cyfinfaza/RSC-LV3-LVBPS/RSC-LV3-LVBPS.kicad_pcb

## KiCad design RSC-LV3-LVBPS.kicad_pcb (2026-06-22)

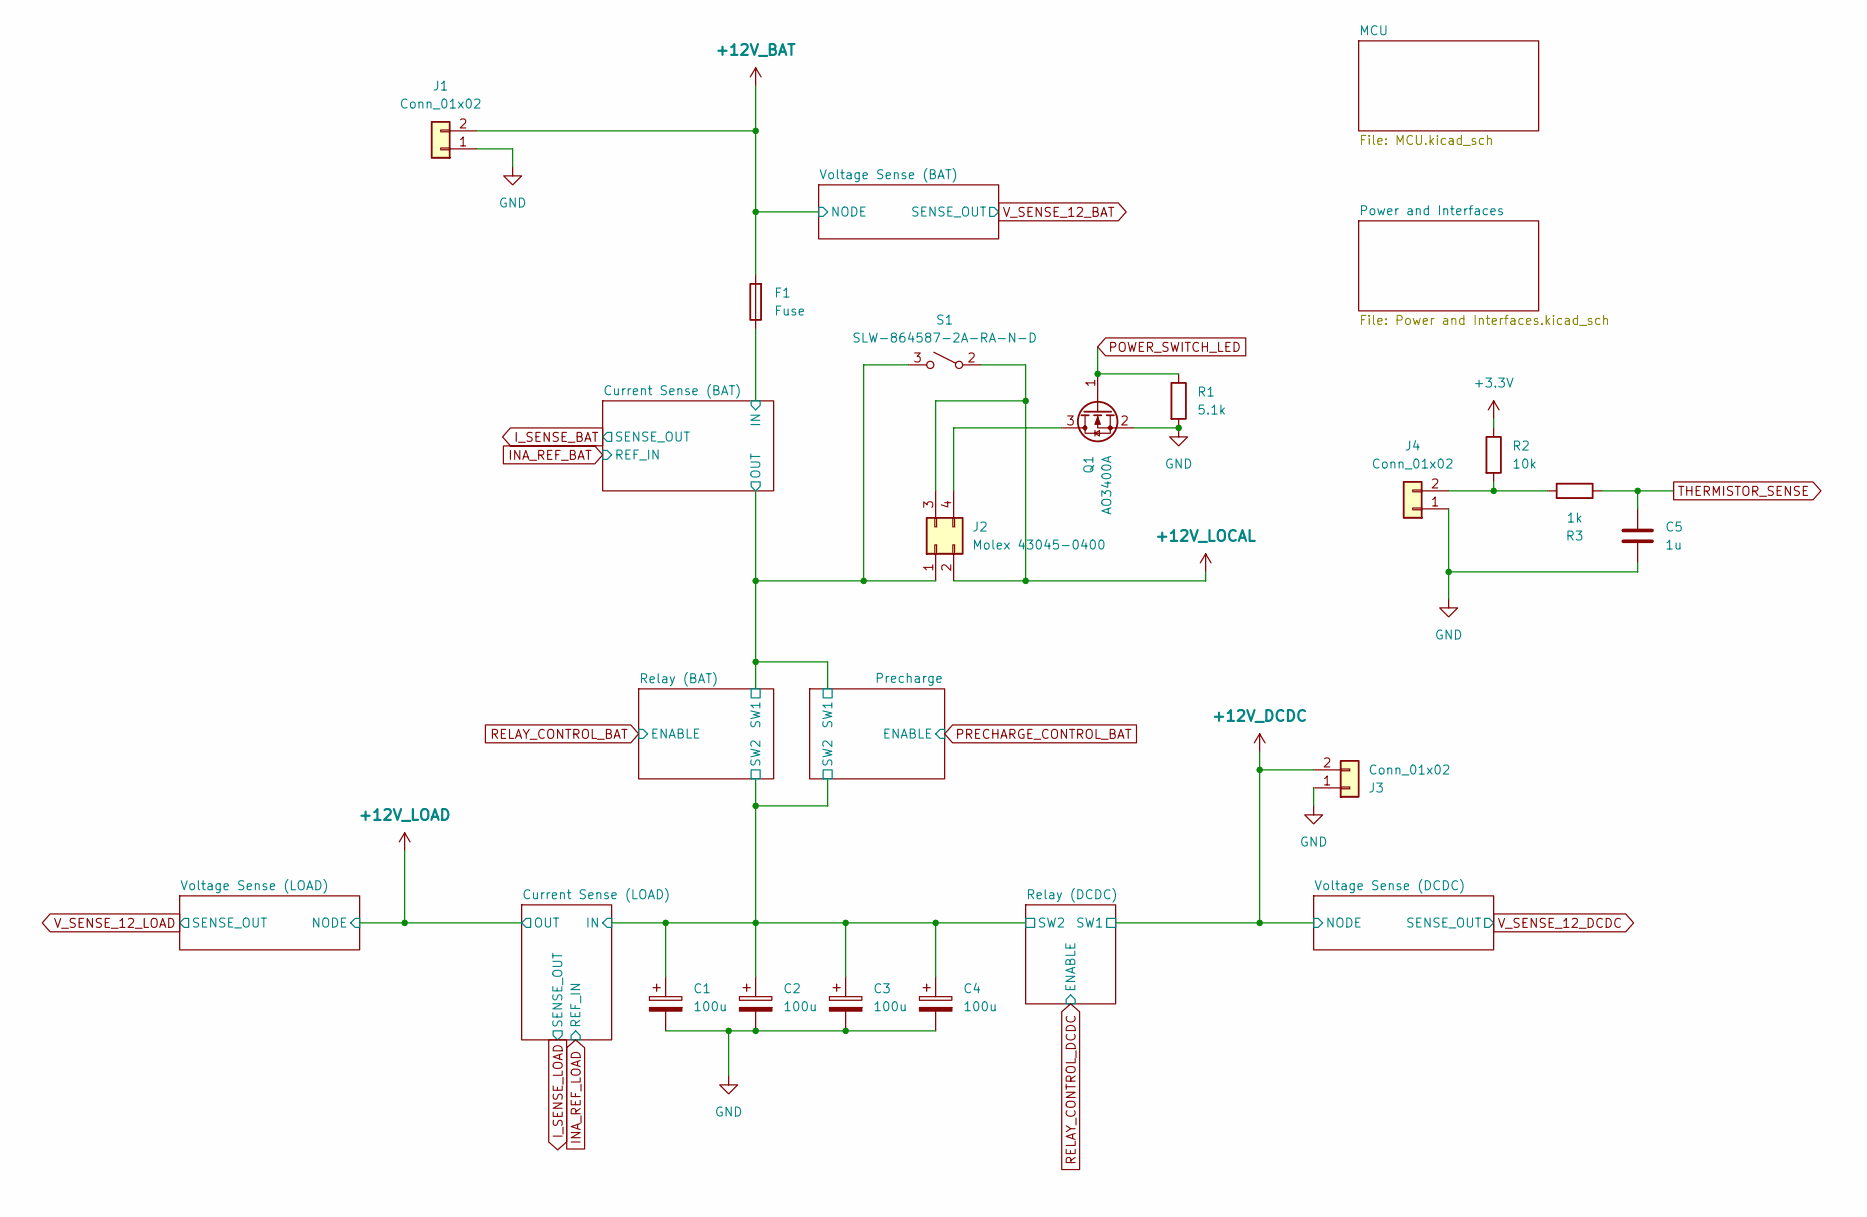
[picture p1: schematic RSC-LV3-LVBPS.kicad_sch]

Parts:
C1, C2, C3, C4: 100u; CP_Radial_D6.3mm_P2.50mm
C5: 1u; C_0603_1608Metric_Pad1.08x0.95mm_HandSolder
F1: Fuse; Fuseholder_Blade_Mini_Keystone_3568
J1, J3, J4: Conn_01x02; Molex_Micro-Fit_3.0_43650-0200_1x02_P3.00mm_Horizontal_Vert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
J2: Molex 43045-0400; Molex_Micro-Fit_3.0_43045-0400_2x02_P3.00mm_Horizontal_Vert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
Q1: AO3400A; SOT-23
R1: 5.1k; R_0603_1608Metric_Pad0.98x0.95mm_HandSolder
R2: 10k; R_0603_1608Metric_Pad0.98x0.95mm_HandSolder
R3: 1k; R_0603_1608Metric_Pad0.98x0.95mm_HandSolder
S1: SLW-864587-2A-RA-N-D; SLW8645872ARAND

Connections:
+3.3V: R2.1; also elsewhere on the board
+12V_BAT: F1.2, J1.2; also elsewhere on the board
+12V_DCDC: J3.2; also elsewhere on the board
+12V_LOCAL: J2.2, J2.3, S1.2 (A); also elsewhere on the board
/Current Sense (BAT)/IN: F1.1; also elsewhere on the board
/Current Sense (BAT)/OUT: J2.1, S1.3 (B); also elsewhere on the board
/Current Sense (LOAD)/IN: C1.1, C2.1, C3.1, C4.1; also elsewhere on the board
GND: C1.2, C2.2, C3.2, C4.2, C5.2, J1.1, J3.1, J4.1, Q1.2 (S), R1.2; also elsewhere on the board
unnamed: J2.4, Q1.3 (D)
unnamed: J4.2, R2.2, R3.2
POWER_SWITCH_LED: Q1.1 (G), R1.1; also elsewhere on the board
THERMISTOR_SENSE: C5.1, R3.1; also elsewhere on the board

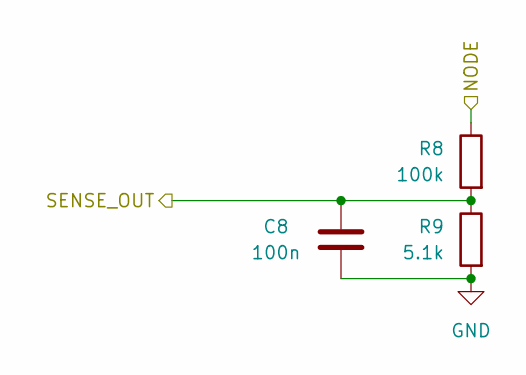
[picture p2: schematic Voltage Sense Network.kicad_sch]

Parts:
C8: 100n; C_0603_1608Metric_Pad1.08x0.95mm_HandSolder
R8: 100k; R_0603_1608Metric_Pad0.98x0.95mm_HandSolder
R9: 5.1k; R_0603_1608Metric_Pad0.98x0.95mm_HandSolder

Connections:
+12V_BAT: R8.1; also elsewhere on the board
GND: C8.2, R9.2; also elsewhere on the board
V_SENSE_12_BAT: C8.1, R8.2, R9.1; also elsewhere on the board

Parts of its further copies:
C9, C10: 100n; C_0603_1608Metric_Pad1.08x0.95mm_HandSolder
R12, R14: 100k; R_0603_1608Metric_Pad0.98x0.95mm_HandSolder
R13, R15: 5.1k; R_0603_1608Metric_Pad0.98x0.95mm_HandSolder

Connections of its further copies:
+12V_DCDC: R14.1; also elsewhere on the board
+12V_LOAD: R12.1; also elsewhere on the board
GND: C9.2, C10.2, R13.2, R15.2; also elsewhere on the board
V_SENSE_12_DCDC: C10.1, R14.2, R15.1; also elsewhere on the board
V_SENSE_12_LOAD: C9.1, R12.2, R13.1; also elsewhere on the board

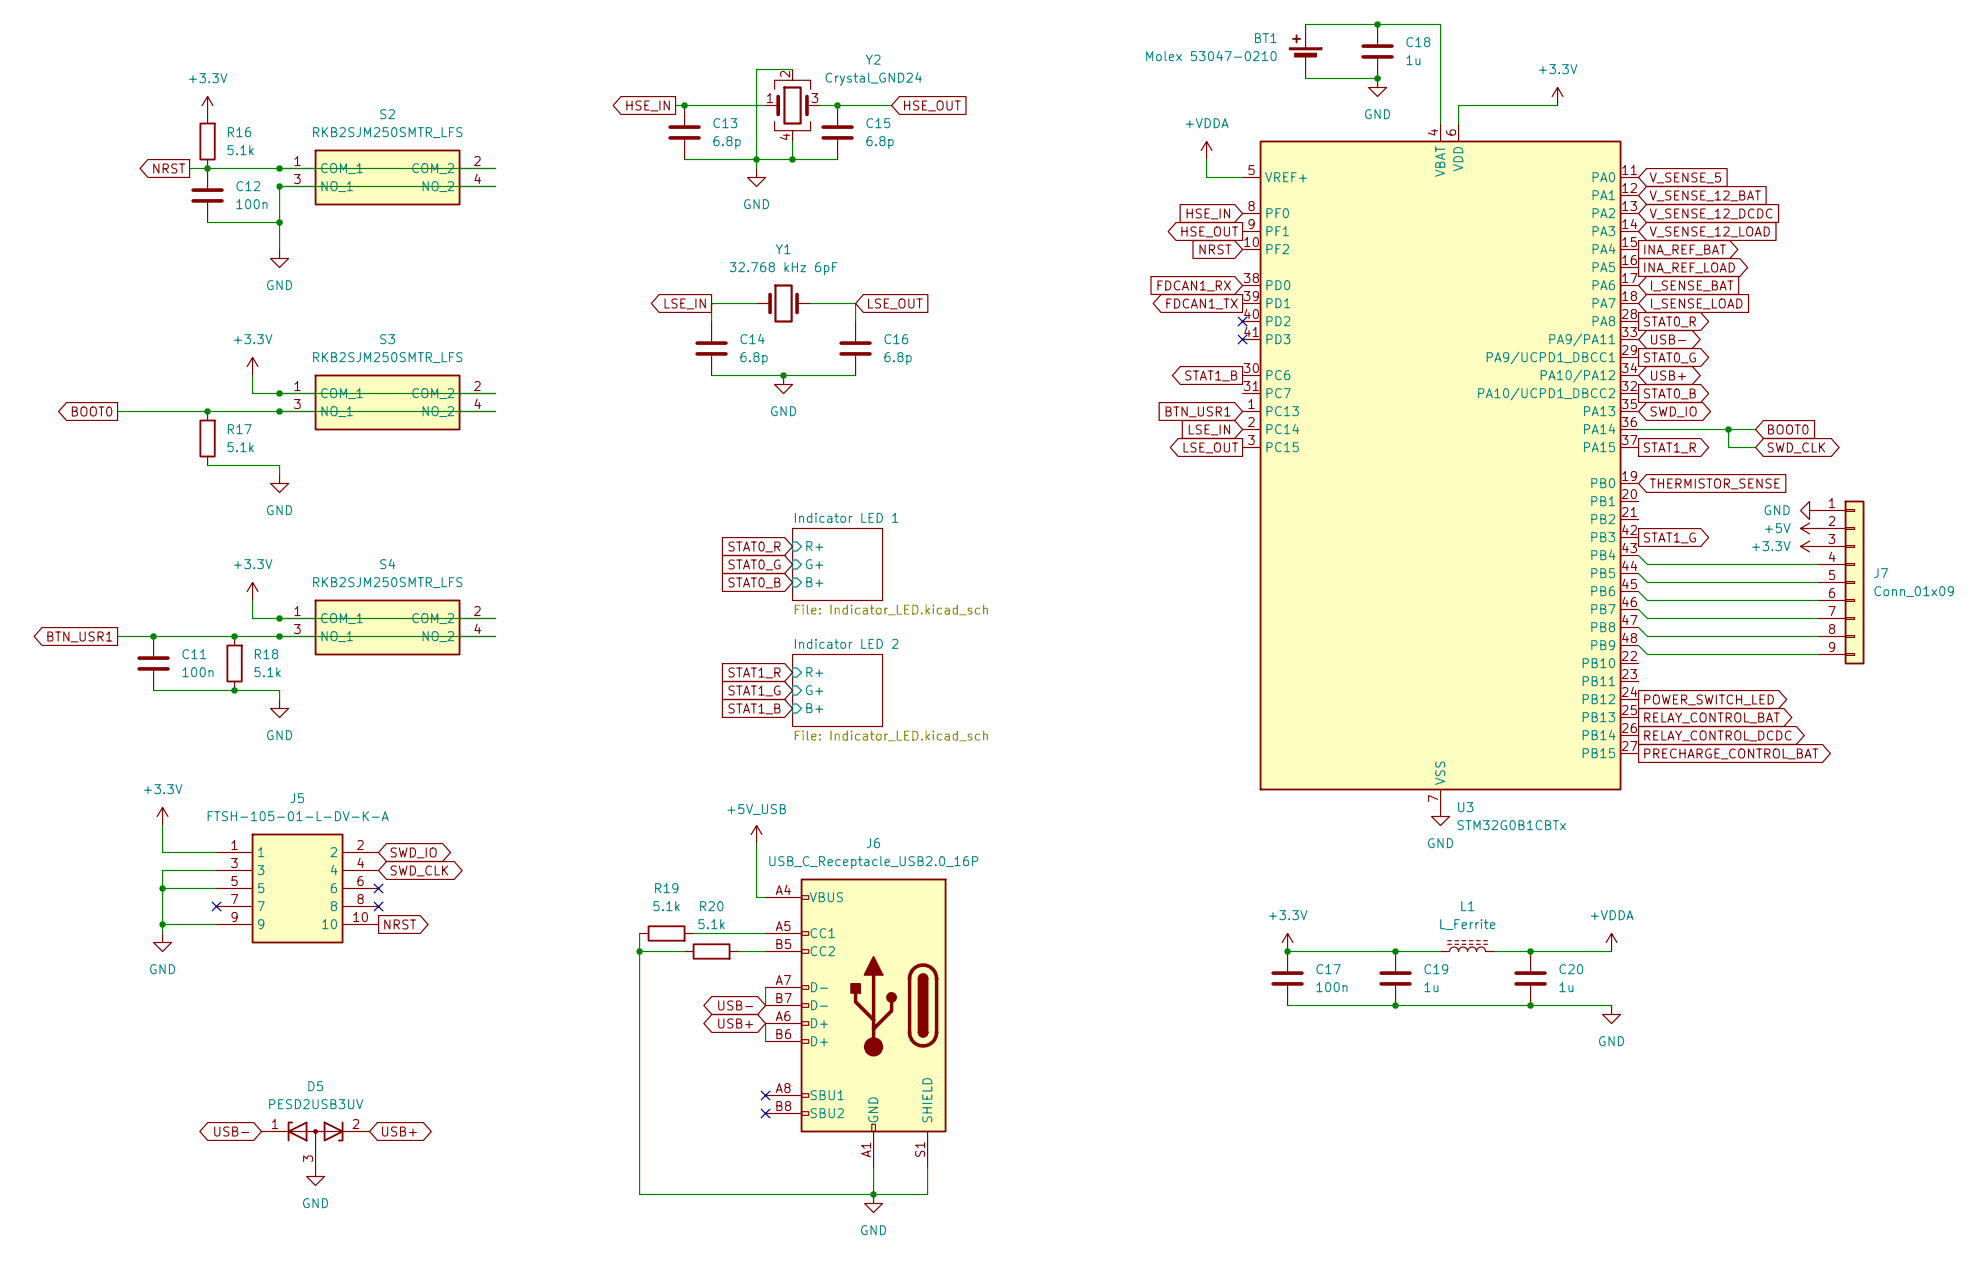
[picture p3: schematic MCU.kicad_sch]

Parts:
BT1: Molex 53047-0210; Molex_PicoBlade_53047-0210_1x02_P1.25mm_Vertical
C11, C12, C17: 100n; C_0603_1608Metric_Pad1.08x0.95mm_HandSolder
C13, C14, C15, C16: 6.8p; C_0603_1608Metric_Pad1.08x0.95mm_HandSolder
C18, C19, C20: 1u; C_0603_1608Metric_Pad1.08x0.95mm_HandSolder
D5: PESD2USB3UV; SOT-23W
J5: FTSH-105-01-L-DV-K-A; FTSH-105-XX-YYY-DV-K-A; Mouser Part Number 200-FTSH10501LDVKA
J6: USB_C_Receptacle_USB2.0_16P; USB_C_Receptacle_HRO_TYPE-C-31-M-12
J7: Conn_01x09; PinHeader_1x09_P2.54mm_Vertical
L1: L_Ferrite; L_0603_1608Metric_Pad1.05x0.95mm_HandSolder
R16, R17, R18, R19, R20: 5.1k; R_0603_1608Metric_Pad0.98x0.95mm_HandSolder
S2, S3, S4: RKB2SJM250SMTR_LFS; RKB2SJM250SMTRLFS; Mouser Part Number 611-RKB2SJM250SMTRLF
U3: STM32G0B1CBTx; LQFP-48_7x7mm_P0.5mm
Y1: 32.768 kHz 6pF; Crystal_C26-LF_D2.1mm_L6.5mm_Horizontal
Y2: Crystal_GND24; Crystal_SMD_3225-4Pin_3.2x2.5mm

Connections:
+3.3V: C17.1, C19.1, J5.1, J7.3, L1.1, R16.2, S3.1 (COM_1), S3.2 (COM_2), S4.1 (COM_1), S4.2 (COM_2), U3.6 (VDD); also elsewhere on the board
+5V: J7.2; also elsewhere on the board
+5V_USB: J6.A4 (VBUS), J6.A9 (VBUS), J6.B4 (VBUS), J6.B9 (VBUS); also elsewhere on the board
+VDDA: C20.1, L1.2, U3.5 (VREF+)
BOOT0: J5.4, R17.2, S3.3 (NO_1), S3.4 (NO_2), U3.36 (PA14)
BTN_USR1: C11.1, R18.2, S4.3 (NO_1), S4.4 (NO_2), U3.1 (PC13)
FDCAN1_RX: U3.38 (PD0); also elsewhere on the board
FDCAN1_TX: U3.39 (PD1); also elsewhere on the board
GND: BT1.2 (-), C11.2, C12.2, C13.2, C14.2, C15.2, C16.2, C17.2, C18.2, C19.2, C20.2, D5.3 (A), J5.3, J5.5, J5.9, J6.A1 (GND), J6.A12 (GND), J6.B1 (GND), J6.B12 (GND), J6.S1 (SHIELD), J7.1, R17.1, R18.1, R19.1, R20.1, S2.3 (NO_1), S2.4 (NO_2), U3.7 (VSS), Y2.2, Y2.4; also elsewhere on the board
HSE_IN: C13.1, U3.8 (PF0), Y2.1
HSE_OUT: C15.1, U3.9 (PF1), Y2.3
INA_REF_BAT: U3.15 (PA4); also elsewhere on the board
INA_REF_LOAD: U3.16 (PA5); also elsewhere on the board
I_SENSE_BAT: U3.17 (PA6); also elsewhere on the board
I_SENSE_LOAD: U3.18 (PA7); also elsewhere on the board
LSE_IN: C14.1, U3.2 (PC14), Y1.1
LSE_OUT: C16.1, U3.3 (PC15), Y1.2
NRST: C12.1, J5.10, R16.1, S2.1 (COM_1), S2.2 (COM_2), U3.10 (PF2)
unnamed: BT1.1 (+), C18.1, U3.4 (VBAT)
unnamed: J6.A5 (CC1), R19.2
unnamed: J6.B5 (CC2), R20.2
unnamed: J7.4, U3.43 (PB4)
unnamed: J7.5, U3.44 (PB5)
unnamed: J7.6, U3.45 (PB6)
unnamed: J7.7, U3.46 (PB7)
unnamed: J7.8, U3.47 (PB8)
unnamed: J7.9, U3.48 (PB9)
POWER_SWITCH_LED: U3.24 (PB12); also elsewhere on the board
PRECHARGE_CONTROL_BAT: U3.27 (PB15); also elsewhere on the board
RELAY_CONTROL_BAT: U3.25 (PB13); also elsewhere on the board
RELAY_CONTROL_DCDC: U3.26 (PB14); also elsewhere on the board
STAT0_B: U3.32 (PA10/UCPD1_DBCC2); also elsewhere on the board
STAT0_G: U3.29 (PA9/UCPD1_DBCC1); also elsewhere on the board
STAT0_R: U3.28 (PA8); also elsewhere on the board
STAT1_B: U3.30 (PC6); also elsewhere on the board
STAT1_G: U3.42 (PB3); also elsewhere on the board
STAT1_R: U3.37 (PA15); also elsewhere on the board
SWD_IO: J5.2, U3.35 (PA13)
THERMISTOR_SENSE: U3.19 (PB0); also elsewhere on the board
USB+: D5.2 (K), J6.A6 (D+), J6.B6 (D+), U3.34 (PA10/PA12)
USB-: D5.1 (K), J6.A7 (D-), J6.B7 (D-), U3.33 (PA9/PA11)
V_SENSE_5: U3.11 (PA0); also elsewhere on the board
V_SENSE_12_BAT: U3.12 (PA1); also elsewhere on the board
V_SENSE_12_DCDC: U3.13 (PA2); also elsewhere on the board
V_SENSE_12_LOAD: U3.14 (PA3); also elsewhere on the board

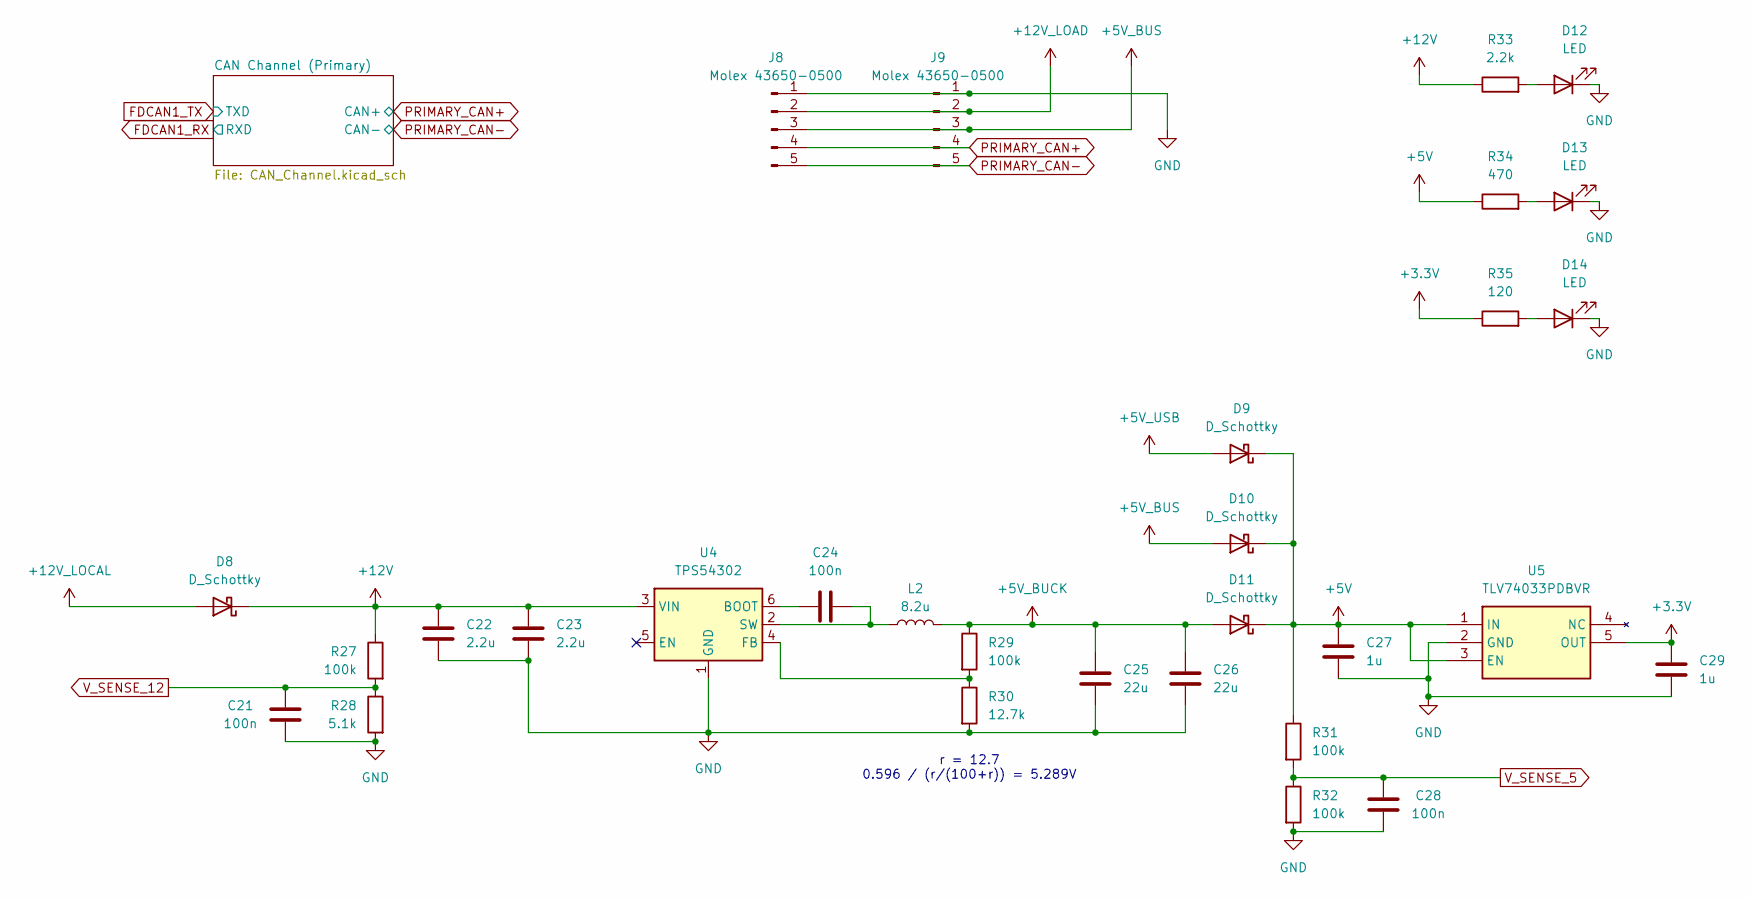
[picture p4: schematic Power and Interfaces.kicad_sch]

Parts:
C21, C24, C28: 100n; C_0603_1608Metric_Pad1.08x0.95mm_HandSolder
C22, C23: 2.2u; C_0603_1608Metric_Pad1.08x0.95mm_HandSolder
C25, C26: 22u; C_1206_3216Metric_Pad1.33x1.80mm_HandSolder
C27, C29: 1u; C_0603_1608Metric_Pad1.08x0.95mm_HandSolder
D8, D9, D10, D11: D_Schottky; D_SOD-123F
D12, D13, D14: LED; LED_0603_1608Metric_Pad1.05x0.95mm_HandSolder
J8, J9: Molex 43650-0500; Molex_Micro-Fit_3.0_43650-0500_1x05_P3.00mm_Horizontal_Vert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
L2: 8.2u; L_Abracon_ASPI-4030S
R27, R29, R31, R32: 100k; R_0603_1608Metric_Pad0.98x0.95mm_HandSolder
R28: 5.1k; R_0603_1608Metric_Pad0.98x0.95mm_HandSolder
R30: 12.7k; R_0603_1608Metric_Pad0.98x0.95mm_HandSolder
R33: 2.2k; R_0603_1608Metric_Pad0.98x0.95mm_HandSolder
R34: 470; R_0603_1608Metric_Pad0.98x0.95mm_HandSolder
R35: 120; R_0603_1608Metric_Pad0.98x0.95mm_HandSolder
U4: TPS54302; SOT-23-6_Handsoldering
U5: TLV74033PDBVR; SOT95P280X145-5N; Mouser Part Number 595-TLV74033PDBVR

Connections:
+3.3V: C29.1, R35.1, U5.5 (OUT); also elsewhere on the board
+5V: C27.1, D9.1 (K), D10.1 (K), D11.1 (K), R31.1, R34.1, U5.1 (IN), U5.3 (EN); also elsewhere on the board
+5V_BUCK: C25.1, C26.1, D11.2 (A), L2.2, R29.1
+5V_BUS: D10.2 (A), J8.3, J9.3
+5V_USB: D9.2 (A); also elsewhere on the board
+12V: C22.1, C23.1, D8.1 (K), R27.1, R33.1, U4.3 (VIN)
+12V_LOAD: J8.2, J9.2; also elsewhere on the board
+12V_LOCAL: D8.2 (A); also elsewhere on the board
GND: C21.2, C22.2, C23.2, C25.2, C26.2, C27.2, C28.2, C29.2, D12.1 (K), D13.1 (K), D14.1 (K), J8.1, J9.1, R28.2, R30.2, R32.2, U4.1 (GND), U5.2 (GND); also elsewhere on the board
unnamed: D12.2 (A), R33.2
unnamed: D13.2 (A), R34.2
unnamed: D14.2 (A), R35.2
unnamed: C24.1, U4.6 (BOOT)
unnamed: R29.2, R30.1, U4.4 (FB)
unnamed: C24.2, L2.1, U4.2 (SW)
PRIMARY_CAN+: J8.4, J9.4; also elsewhere on the board
PRIMARY_CAN-: J8.5, J9.5; also elsewhere on the board
V_SENSE_5: C28.1, R31.2, R32.1; also elsewhere on the board
V_SENSE_12: C21.1, R27.2, R28.1

Notes on the sheet:
r = 12.7 0.596 / (r/(100+r)) = 5.289V

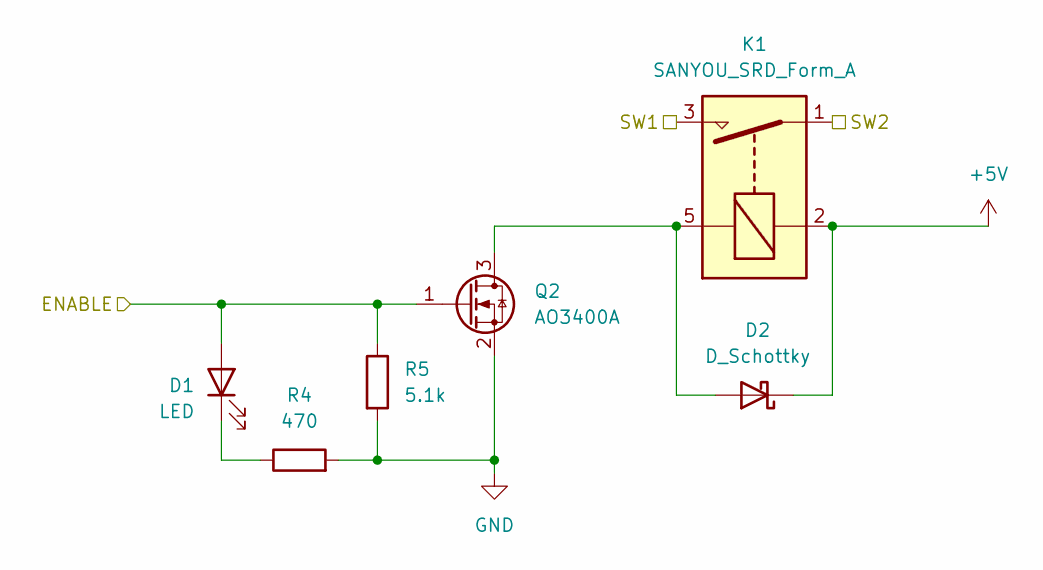
[picture p5: schematic Relay.kicad_sch]

Parts:
D1: LED; LED_0603_1608Metric_Pad1.05x0.95mm_HandSolder
D2: D_Schottky; D_SOD-123F
K1: SANYOU_SRD_Form_A; Relay_SPST_SANYOU_SRD_Series_Form_A
Q2: AO3400A; SOT-23
R4: 470; R_0603_1608Metric_Pad0.98x0.95mm_HandSolder
R5: 5.1k; R_0603_1608Metric_Pad0.98x0.95mm_HandSolder

Connections:
+5V: D2.1 (K), K1.2; also elsewhere on the board
+12V_DCDC: K1.3; also elsewhere on the board
/Current Sense (LOAD)/IN: K1.1; also elsewhere on the board
GND: Q2.2 (S), R4.2, R5.2; also elsewhere on the board
unnamed: D1.1 (K), R4.1
unnamed: D2.2 (A), K1.5, Q2.3 (D)
RELAY_CONTROL_DCDC: D1.2 (A), Q2.1 (G), R5.1; also elsewhere on the board

Parts of its further copies:
D3: LED; LED_0603_1608Metric_Pad1.05x0.95mm_HandSolder
D4: D_Schottky; D_SOD-123F
K2: SANYOU_SRD_Form_A; Relay_SPST_SANYOU_SRD_Series_Form_A
Q3: AO3400A; SOT-23
R10: 470; R_0603_1608Metric_Pad0.98x0.95mm_HandSolder
R11: 5.1k; R_0603_1608Metric_Pad0.98x0.95mm_HandSolder

Connections of its further copies:
+5V: D4.1 (K), K2.2; also elsewhere on the board
/Current Sense (BAT)/OUT: K2.3; also elsewhere on the board
/Current Sense (LOAD)/IN: K2.1; also elsewhere on the board
GND: Q3.2 (S), R10.2, R11.2; also elsewhere on the board
unnamed: D3.1 (K), R10.1
unnamed: D4.2 (A), K2.5, Q3.3 (D)
RELAY_CONTROL_BAT: D3.2 (A), Q3.1 (G), R11.1; also elsewhere on the board

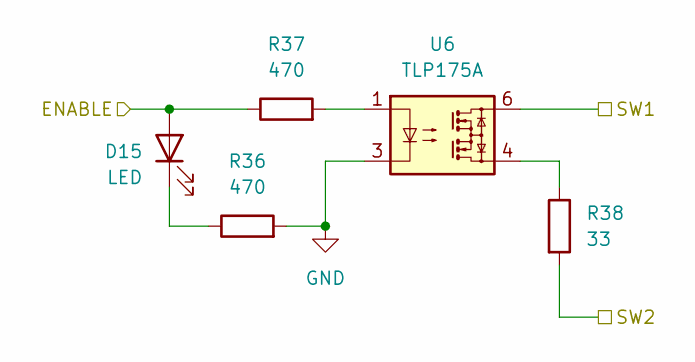
[picture p6: schematic Precharge.kicad_sch]

Parts:
D15: LED; LED_0603_1608Metric_Pad1.05x0.95mm_HandSolder
R36, R37: 470; R_0603_1608Metric_Pad0.98x0.95mm_HandSolder
R38: 33; R_2512_6332Metric
U6: TLP175A; Toshiba_SOIC-4-6_4.4x3.6mm_P1.27mm

Connections:
/Current Sense (BAT)/OUT: U6.6; also elsewhere on the board
/Current Sense (LOAD)/IN: R38.2; also elsewhere on the board
GND: R36.2, U6.3; also elsewhere on the board
unnamed: D15.1 (K), R36.1
unnamed: R37.2, U6.1
unnamed: R38.1, U6.4
PRECHARGE_CONTROL_BAT: D15.2 (A), R37.1; also elsewhere on the board

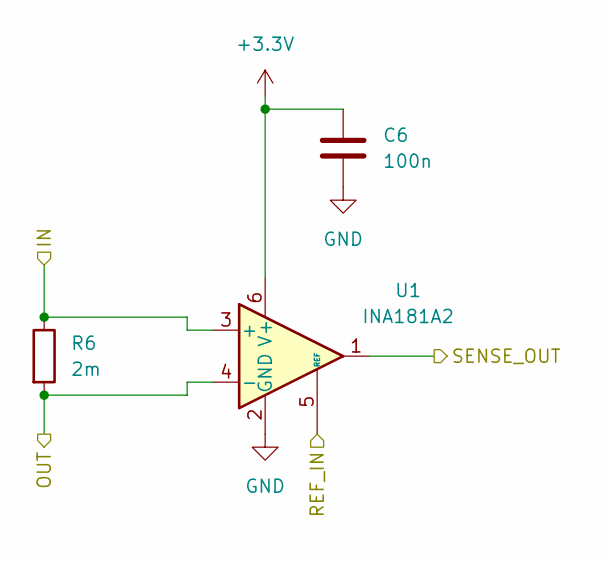
[picture p7: schematic Current Sense.kicad_sch]

Parts:
C6: 100n; C_0603_1608Metric_Pad1.08x0.95mm_HandSolder
R6: 2m; R_1206_3216Metric_Pad1.30x1.75mm_HandSolder
U1: INA181A2; SOT-23-6_Handsoldering

Connections:
+3.3V: C6.1, U1.6 (V+); also elsewhere on the board
/Current Sense (BAT)/IN: R6.1, U1.3 (+); also elsewhere on the board
/Current Sense (BAT)/OUT: R6.2, U1.4 (-); also elsewhere on the board
GND: C6.2, U1.2 (GND); also elsewhere on the board
INA_REF_BAT: U1.5 (REF); also elsewhere on the board
I_SENSE_BAT: U1.1; also elsewhere on the board

Parts of its further copies:
C7: 100n; C_0603_1608Metric_Pad1.08x0.95mm_HandSolder
R7: 2m; R_1206_3216Metric_Pad1.30x1.75mm_HandSolder
U2: INA181A2; SOT-23-6_Handsoldering

Connections of its further copies:
+3.3V: C7.1, U2.6 (V+); also elsewhere on the board
+12V_LOAD: R7.2, U2.4 (-); also elsewhere on the board
/Current Sense (LOAD)/IN: R7.1, U2.3 (+); also elsewhere on the board
GND: C7.2, U2.2 (GND); also elsewhere on the board
INA_REF_LOAD: U2.5 (REF); also elsewhere on the board
I_SENSE_LOAD: U2.1; also elsewhere on the board

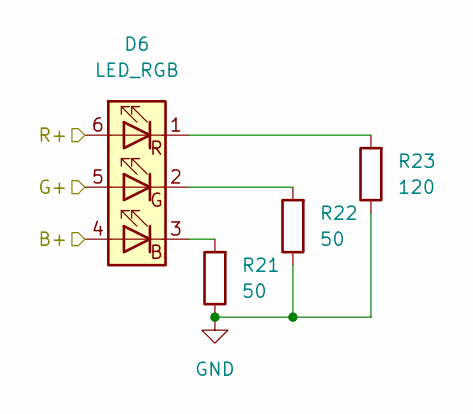
[picture p8: schematic Indicator_LED.kicad_sch]

Parts:
D6: LED_RGB; LED_RGB_5050-6
R21, R22: 50; R_0603_1608Metric_Pad0.98x0.95mm_HandSolder
R23: 120; R_0603_1608Metric_Pad0.98x0.95mm_HandSolder

Connections:
GND: R21.1, R22.1, R23.1; also elsewhere on the board
unnamed: D6.3 (BK), R21.2
unnamed: D6.2 (GK), R22.2
unnamed: D6.1 (RK), R23.2
STAT0_B: D6.4 (BA); also elsewhere on the board
STAT0_G: D6.5 (GA); also elsewhere on the board
STAT0_R: D6.6 (RA); also elsewhere on the board

Parts of its further copies:
D7: LED_RGB; LED_RGB_5050-6
R24, R25: 50; R_0603_1608Metric_Pad0.98x0.95mm_HandSolder
R26: 120; R_0603_1608Metric_Pad0.98x0.95mm_HandSolder

Connections of its further copies:
GND: R24.1, R25.1, R26.1; also elsewhere on the board
unnamed: D7.3 (BK), R24.2
unnamed: D7.2 (GK), R25.2
unnamed: D7.1 (RK), R26.2
STAT1_B: D7.4 (BA); also elsewhere on the board
STAT1_G: D7.5 (GA); also elsewhere on the board
STAT1_R: D7.6 (RA); also elsewhere on the board

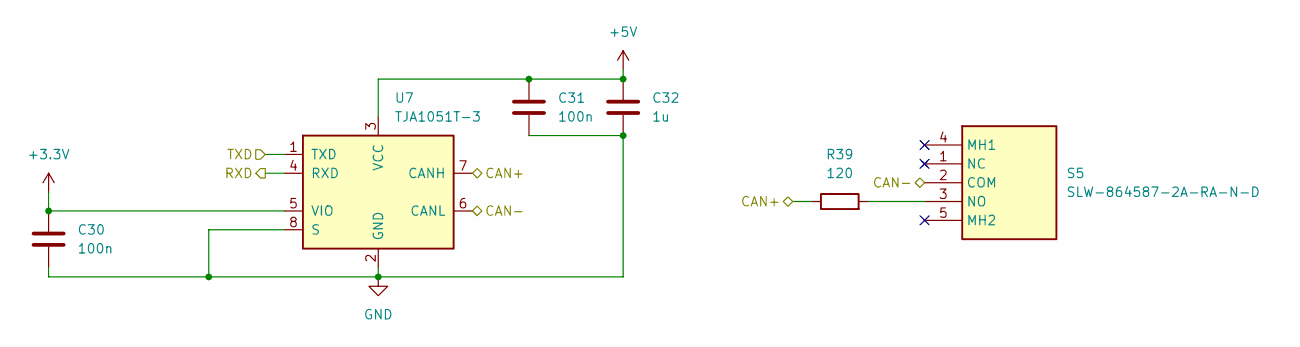
[picture p9: schematic CAN_Channel.kicad_sch]

Parts:
C30, C31: 100n; C_0603_1608Metric_Pad1.08x0.95mm_HandSolder
C32: 1u; C_0603_1608Metric_Pad1.08x0.95mm_HandSolder
R39: 120; R_0603_1608Metric_Pad0.98x0.95mm_HandSolder
S5: SLW-864587-2A-RA-N-D; SLW8645872ARAND; Mouser Part Number 179-SLW8645872ARAND
U7: TJA1051T-3; SOIC-8_3.9x4.9mm_P1.27mm

Connections:
+3.3V: C30.1, U7.5 (VIO); also elsewhere on the board
+5V: C31.1, C32.1, U7.3 (VCC); also elsewhere on the board
FDCAN1_RX: U7.4 (RXD); also elsewhere on the board
FDCAN1_TX: U7.1 (TXD); also elsewhere on the board
GND: C30.2, C31.2, C32.2, U7.2 (GND), U7.8 (S); also elsewhere on the board
unnamed: R39.2, S5.3 (NO)
PRIMARY_CAN+: R39.1, U7.7 (CANH); also elsewhere on the board
PRIMARY_CAN-: S5.2 (COM), U7.6 (CANL); also elsewhere on the board

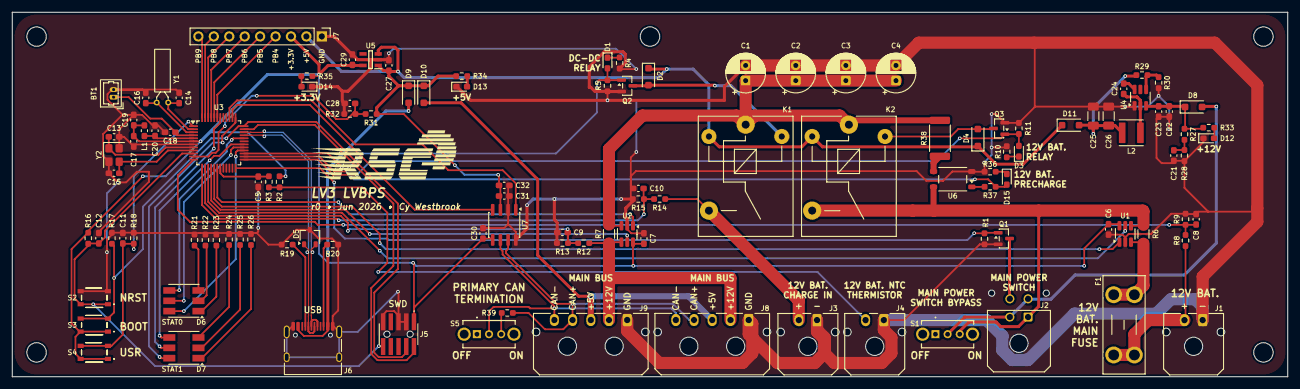
[picture p10: board RSC-LV3-LVBPS.kicad_pcb from above]

Board: 2 copper layers, 210.0 x 60.0 mm, 118 parts (0 on the bottom side), 80 nets.
