cyfinfaza/RSC-LV3-LVBPS/RSC_LV3_LVBPS.kicad_pcb

## KiCad design RSC_LV3_LVBPS.kicad_pcb (2026-06-03)

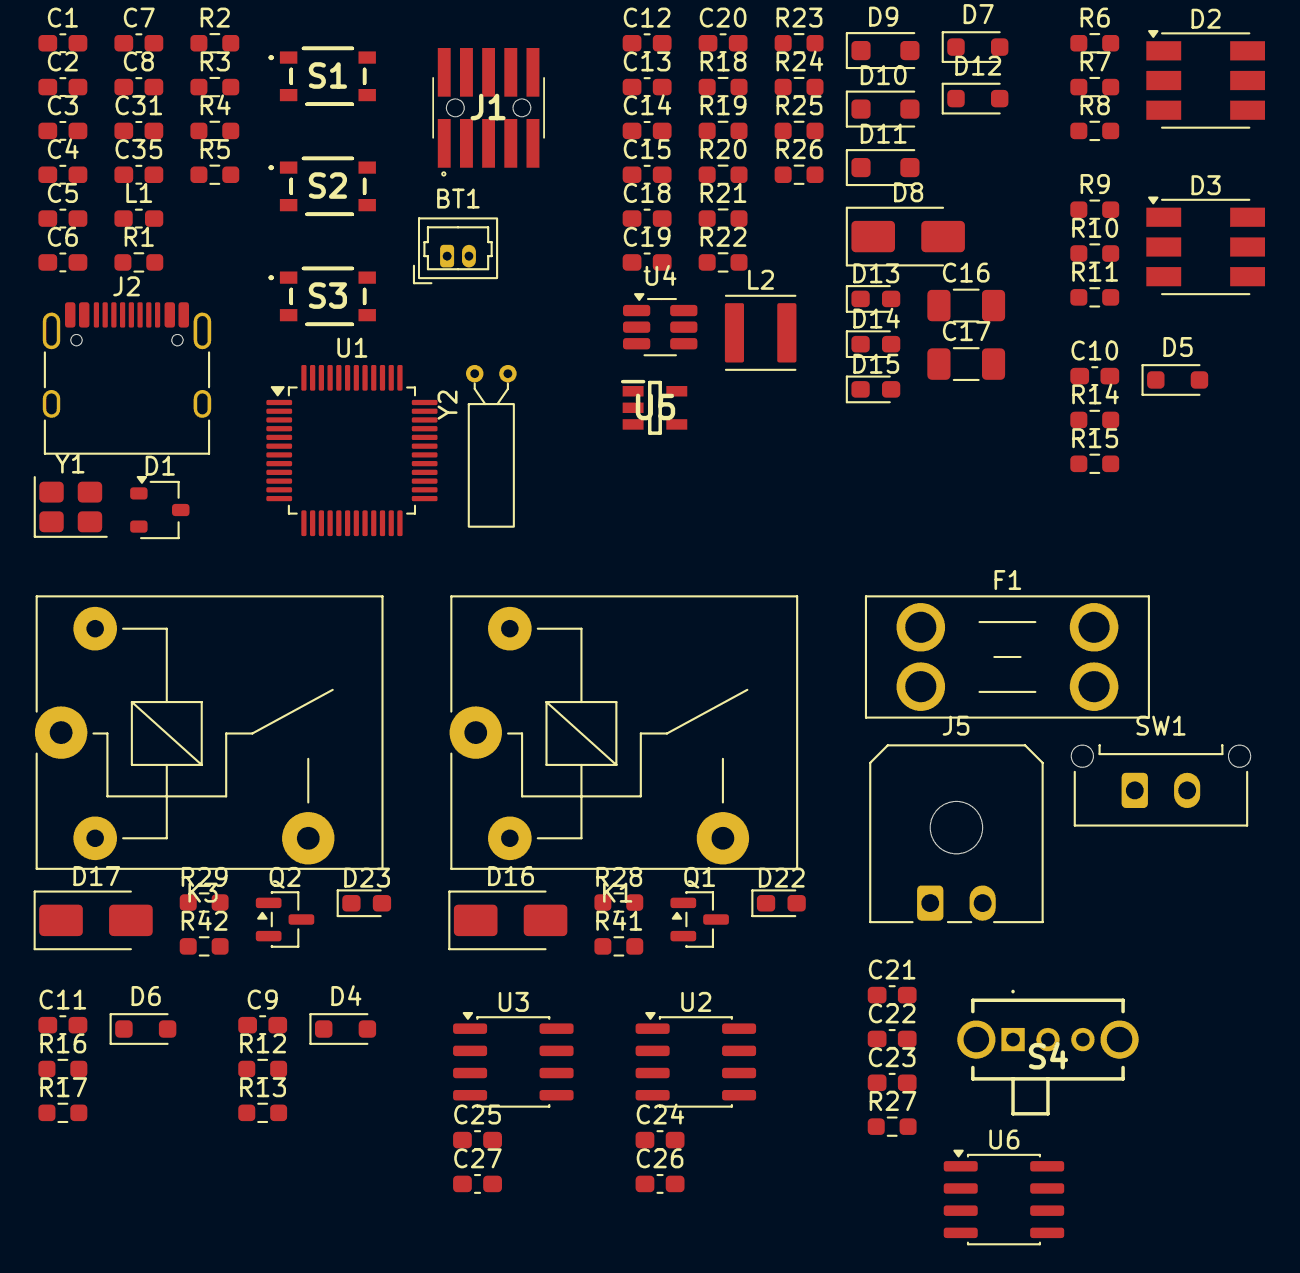
[picture p11: board RSC_LV3_LVBPS.kicad_pcb from above]

Board: 2 copper layers, 103 parts (0 on the bottom side), 62 nets, no tracks yet.

Parts:
BT1: Molex 53047-0210; Molex_PicoBlade_53047-0210_1x02_P1.25mm_Vertical
C1, C2, C5, C9, C10, C11, C12, C15, C19, C21, C22, C24, C25: 100n; C_0603_1608Metric_Pad1.08x0.95mm_HandSolder
C3, C4, C8, C31: 6.8p; C_0603_1608Metric_Pad1.08x0.95mm_HandSolder
C6, C7, C18, C20, C23, C35: 1u; C_0603_1608Metric_Pad1.08x0.95mm_HandSolder
C13, C14: 2.2u; C_0603_1608Metric_Pad1.08x0.95mm_HandSolder
C16, C17: 22u; C_1206_3216Metric_Pad1.33x1.80mm_HandSolder
C26, C27: 1n; C_0603_1608Metric_Pad1.08x0.95mm_HandSolder
D1: PESD2USB3UV; SOT-23W
D2, D3: LED_RGB; LED_RGB_5050-6
D4, D5, D6, D7, D12: D_Zener; D_SOD-323_HandSoldering
D8, D16, D17: D_Schottky; D_SMA
D9, D10, D11: D_Schottky; D_SOD-123F
D13, D14, D15, D22, D23: LED; LED_0603_1608Metric_Pad1.05x0.95mm_HandSolder
F1: Fuse; Fuseholder_Blade_Mini_Keystone_3568
J1: FTSH-105-01-L-DV-K-A; FTSH-105-XX-YYY-DV-K-A
J2: USB_C_Receptacle_USB2.0_16P; USB_C_Receptacle_HRO_TYPE-C-31-M-12
J5: Conn_01x02; Molex_Micro-Fit_3.0_43650-0200_1x02_P3.00mm_Horizontal
K1, K3: Relay_SPST-NO; Relay_SPST_SANYOU_SRD_Series_Form_A
L1: L_Ferrite; L_0603_1608Metric_Pad1.05x0.95mm_HandSolder
L2: 8.2u; L_Abracon_ASPI-4030S
Q1, Q2: AO3400A; SOT-23
R1, R2, R3, R4, R5, R13, R15, R17, R19, R28, R29: 5.1k; R_0603_1608Metric_Pad0.98x0.95mm_HandSolder
R6, R7, R9, R10: 50; R_0603_1608Metric_Pad0.98x0.95mm_HandSolder
R8, R11, R26, R27: 120; R_0603_1608Metric_Pad0.98x0.95mm_HandSolder
R12, R14, R16, R18, R20, R22, R23: 100k; R_0603_1608Metric_Pad0.98x0.95mm_HandSolder
R21: 12.7k; R_0603_1608Metric_Pad0.98x0.95mm_HandSolder
R24: 2.2k; R_0603_1608Metric_Pad0.98x0.95mm_HandSolder
R25, R41, R42: 470; R_0603_1608Metric_Pad0.98x0.95mm_HandSolder
S1, S2, S3: RKB2SJM250SMTR_LFS; RKB2SJM250SMTRLFS
S4: SLW-864587-2A-RA-N-D; SLW8645872ARAND
SW1: SW_SPST; Molex_Micro-Fit_3.0_43650-0215_1x02_P3.00mm_Vertical
U1: STM32G0B1CBTx; LQFP-48_7x7mm_P0.5mm
U2, U3: ACS711xLCTR-12AB; SOIC-8_3.9x4.9mm_P1.27mm
U4: TPS54302; SOT-23-6_Handsoldering
U5: TLV74033PDBVR; SOT95P280X145-5N
U6: TJA1051T-3; SOIC-8_3.9x4.9mm_P1.27mm
Y1: Crystal_GND24; Crystal_SMD_3225-4Pin_3.2x2.5mm
Y2: 32.768 kHz 6pF; Crystal_C26-LF_D2.1mm_L6.5mm_Horizontal

Connections:
+3.3V: C5.1, C6.1, C20.1, C21.1, C24.1, C25.1, J1.1, L1.1, R1.2, R26.1, S2.1 (COM_1), S2.2 (COM_2), S3.1 (COM_1), S3.2 (COM_2), U1.6 (VDD), U2.8 (VCC), U3.8 (VCC), U5.5 (OUT), U6.5 (VIO)
+5V: C18.1, C22.1, C23.1, D9.1 (K), D10.1 (K), D11.1 (K), D16.1 (K), D17.1 (K), R22.1, R25.1, U5.1 (IN), U5.3 (EN), U6.3 (VCC)
+5V_BUCK: C16.1, C17.1, D11.2 (A), L2.2, R20.1
+5V_USB: D9.2 (A), J2.A4 (VBUS), J2.A9 (VBUS), J2.B4 (VBUS), J2.B9 (VBUS)
+12V: C13.1, C14.1, D8.1 (K), R18.1, R24.1, U4.3 (VIN)
+12V_BAT: F1.2, J5.2, R12.1
+12V_LOAD: R14.1, U3.3 (IP-), U3.4 (IP-)
+12V_LOCAL: D8.2 (A), SW1.1 (A)
+VDDA: C7.1, L1.2, U1.5 (VREF+)
/Current Sense (BAT)/IN: F1.1, U2.1 (IP+), U2.2 (IP+)
/Current Sense (BAT)/OUT: SW1.2 (B), U2.3 (IP-), U2.4 (IP-)
/Current Sense (LOAD)/IN: U3.1 (IP+), U3.2 (IP+)
BOOT0: J1.4, R2.2, S2.3 (NO_1), S2.4 (NO_2), U1.36 (PA14)
BTN_USR1: C1.1, R3.2, S3.3 (NO_1), S3.4 (NO_2), U1.1 (PC13)
FDCAN1_RX: U1.38 (PD0), U6.4 (RXD)
FDCAN1_TX: U1.39 (PD1), U6.1 (TXD)
GND: BT1.2 (-), C1.2, C2.2, C3.2, C4.2, C5.2, C6.2, C7.2, C8.2, C9.2, C10.2, C11.2, C12.2, C13.2, C14.2, C16.2, C17.2, C18.2, C19.2, C20.2, C21.2, C22.2, C23.2, C24.2, C25.2, C26.2, C27.2, C31.2, C35.2, D1.3 (A), D4.2 (A), D5.2 (A), D6.2 (A), D7.2 (A), D12.2 (A), D13.1 (K), D14.1 (K), D15.1 (K), J1.3, J1.5, J1.9, J2.A1 (GND), J2.A12 (GND), J2.B1 (GND), J2.B12 (GND), J5.1, Q1.2 (S), Q2.2 (S), R2.1, R3.1, R4.1, R5.1, R6.1, R7.1, R8.1, R9.1, R10.1, R11.1, R13.2, R15.2, R17.2, R19.2, R21.2, R23.2, R28.2, R29.2, R41.2, R42.2, S1.3 (NO_1), S1.4 (NO_2), U1.7 (VSS), U2.5 (GND), U3.5 (GND), U4.1 (GND), U5.2 (GND), U6.2 (GND), U6.8 (S), Y1.2, Y1.4
HSE_IN: C3.1, U1.8 (PF0), Y1.1
HSE_OUT: C4.1, U1.9 (PF1), Y1.3
I_SENSE_BAT: C26.1, U1.15 (PA4), U2.7 (VIOUT)
I_SENSE_LOAD: C27.1, U1.16 (PA5), U3.7 (VIOUT)
LSE_IN: C8.1, U1.2 (PC14), Y2.1
LSE_OUT: C31.1, U1.3 (PC15), Y2.2
NRST: C2.1, J1.10, R1.1, S1.1 (COM_1), S1.2 (COM_2), U1.10 (PF2)
unnamed: BT1.1 (+), C35.1, U1.4 (VBAT)
unnamed: D2.3 (BK), R6.2
unnamed: D2.2 (GK), R7.2
unnamed: D2.1 (RK), R8.2
unnamed: D3.3 (BK), R9.2
unnamed: D3.2 (GK), R10.2
unnamed: D3.1 (RK), R11.2
unnamed: D13.2 (A), R24.2
unnamed: D14.2 (A), R25.2
unnamed: D15.2 (A), R26.2
unnamed: D16.2 (A), Q1.3 (D)
unnamed: D17.2 (A), Q2.3 (D)
unnamed: D22.1 (K), R41.1
unnamed: D23.1 (K), R42.1
unnamed: J2.A5 (CC1), R4.2
unnamed: J2.B5 (CC2), R5.2
unnamed: R27.2, S4.3 (NO)
unnamed: C15.1, U4.6 (BOOT)
unnamed: R20.2, R21.1, U4.4 (FB)
unnamed: C15.2, L2.1, U4.2 (SW)
PRIMARY_CAN+: R27.1, U6.7 (CANH)
PRIMARY_CAN-: S4.2 (COM), U6.6 (CANL)
RELAY_CONTROL_BAT: D23.2 (A), Q2.1 (G), R29.1, U1.19 (PB0)
RELAY_CONTROL_DCDC: D22.2 (A), Q1.1 (G), R28.1, U1.20 (PB1)
STAT0_B: D2.4 (BA), U1.32 (PA10/UCPD1_DBCC2)
STAT0_G: D2.5 (GA), U1.29 (PA9/UCPD1_DBCC1)
STAT0_R: D2.6 (RA), U1.28 (PA8)
STAT1_B: D3.4 (BA), U1.30 (PC6)
STAT1_G: D3.5 (GA), U1.42 (PB3)
STAT1_R: D3.6 (RA), U1.37 (PA15)
SWD_IO: J1.2, U1.35 (PA13)
USB+: D1.2 (K), J2.A6 (D+), J2.B6 (D+), U1.34 (PA10/PA12)
USB-: D1.1 (K), J2.A7 (D-), J2.B7 (D-), U1.33 (PA9/PA11)
V_SENSE_5: C19.1, D12.1 (K), R22.2, R23.1, U1.11 (PA0)
V_SENSE_12: C12.1, D7.1 (K), R18.2, R19.1
V_SENSE_12_BAT: C9.1, D4.1 (K), R12.2, R13.1, U1.12 (PA1)
V_SENSE_12_DCDC: C11.1, D6.1 (K), R16.2, R17.1, U1.13 (PA2)
V_SENSE_12_LOAD: C10.1, D5.1 (K), R14.2, R15.1, U1.14 (PA3)
