cyfinfaza/RSC-LV3-LVBPS/(commit log)

2026-06-03 add MCU and power circuits
    [CAN_Channel.kicad_sch, Current Sense.kicad_sch, Indicator_LED.kicad_sch, MCU.kicad_sch, Power and Interfaces.kicad_sch, RSC_LV3_LVBPS.kicad_pcb, RSC_LV3_LVBPS.kicad_sch]
2026-06-03 rename project to use dashes instead of underscores for consistency
    [CAN_Channel.kicad_sch, Current Sense.kicad_sch, Indicator_LED.kicad_sch, MCU.kicad_sch, Power and Interfaces.kicad_sch, RSC-LV3-LVBPS.kicad_pcb, RSC-LV3-LVBPS.kicad_sch, Relay.kicad_sch]
2026-06-11 more schematic work and initial layout
    [CAN_Channel.kicad_sch, Current Sense.kicad_sch, MCU.kicad_sch, Power and Interfaces.kicad_sch, Precharge.kicad_sch, RSC-LV3-LVBPS.kicad_pcb, RSC-LV3-LVBPS.kicad_sch, Relay.kicad_sch]
2026-06-13 more layout work
    [CAN_Channel.kicad_sch, Current Sense.kicad_sch, Indicator_LED.kicad_sch, MCU.kicad_sch, Power and Interfaces.kicad_sch, Precharge.kicad_sch, RSC-LV3-LVBPS.kicad_pcb, RSC-LV3-LVBPS.kicad_sch]
2026-06-14 schematic changes and initial routing
    [CAN_Channel.kicad_sch, Current Sense.kicad_sch, Indicator_LED.kicad_sch, MCU.kicad_sch, Power and Interfaces.kicad_sch, Precharge.kicad_sch, RSC-LV3-LVBPS.kicad_pcb, RSC-LV3-LVBPS.kicad_sch]
2026-06-15 finished layout, routing, and silkscreen
    [CAN_Channel.kicad_sch, Current Sense.kicad_sch, Indicator_LED.kicad_sch, MCU.kicad_sch, Power and Interfaces.kicad_sch, Precharge.kicad_sch, RSC-LV3-LVBPS.kicad_sch, Relay.kicad_sch]
2026-06-16 minor layout and silkscreen tweaks
    [CAN_Channel.kicad_sch, Current Sense.kicad_sch, Indicator_LED.kicad_sch, MCU.kicad_sch, Power and Interfaces.kicad_sch, Precharge.kicad_sch, RSC-LV3-LVBPS.kicad_pcb, RSC-LV3-LVBPS.kicad_sch]
2026-06-22 r0 final
    [CAN_Channel.kicad_sch, Indicator_LED.kicad_sch, MCU.kicad_sch, Power and Interfaces.kicad_sch, Precharge.kicad_sch, RSC-LV3-LVBPS.kicad_pcb, Relay.kicad_sch, Voltage Sense Network.kicad_sch]
